darkopancev517/microbyte-rp2040/release/microbyte-rp2040-v1.0-rev/README.md

RELEASE NOTE:
    - microbyte-rp2040-v1.0-rev
        - Fixed tooling holes positions
        - Fixed tooling holes line width
