darkopancev517/microbyte-rp2040/microbyte-rp2040/microbyte-rp2040.kicad_pcb

## KiCad design microbyte-rp2040/microbyte-rp2040.kicad_pcb (2021-08-23)

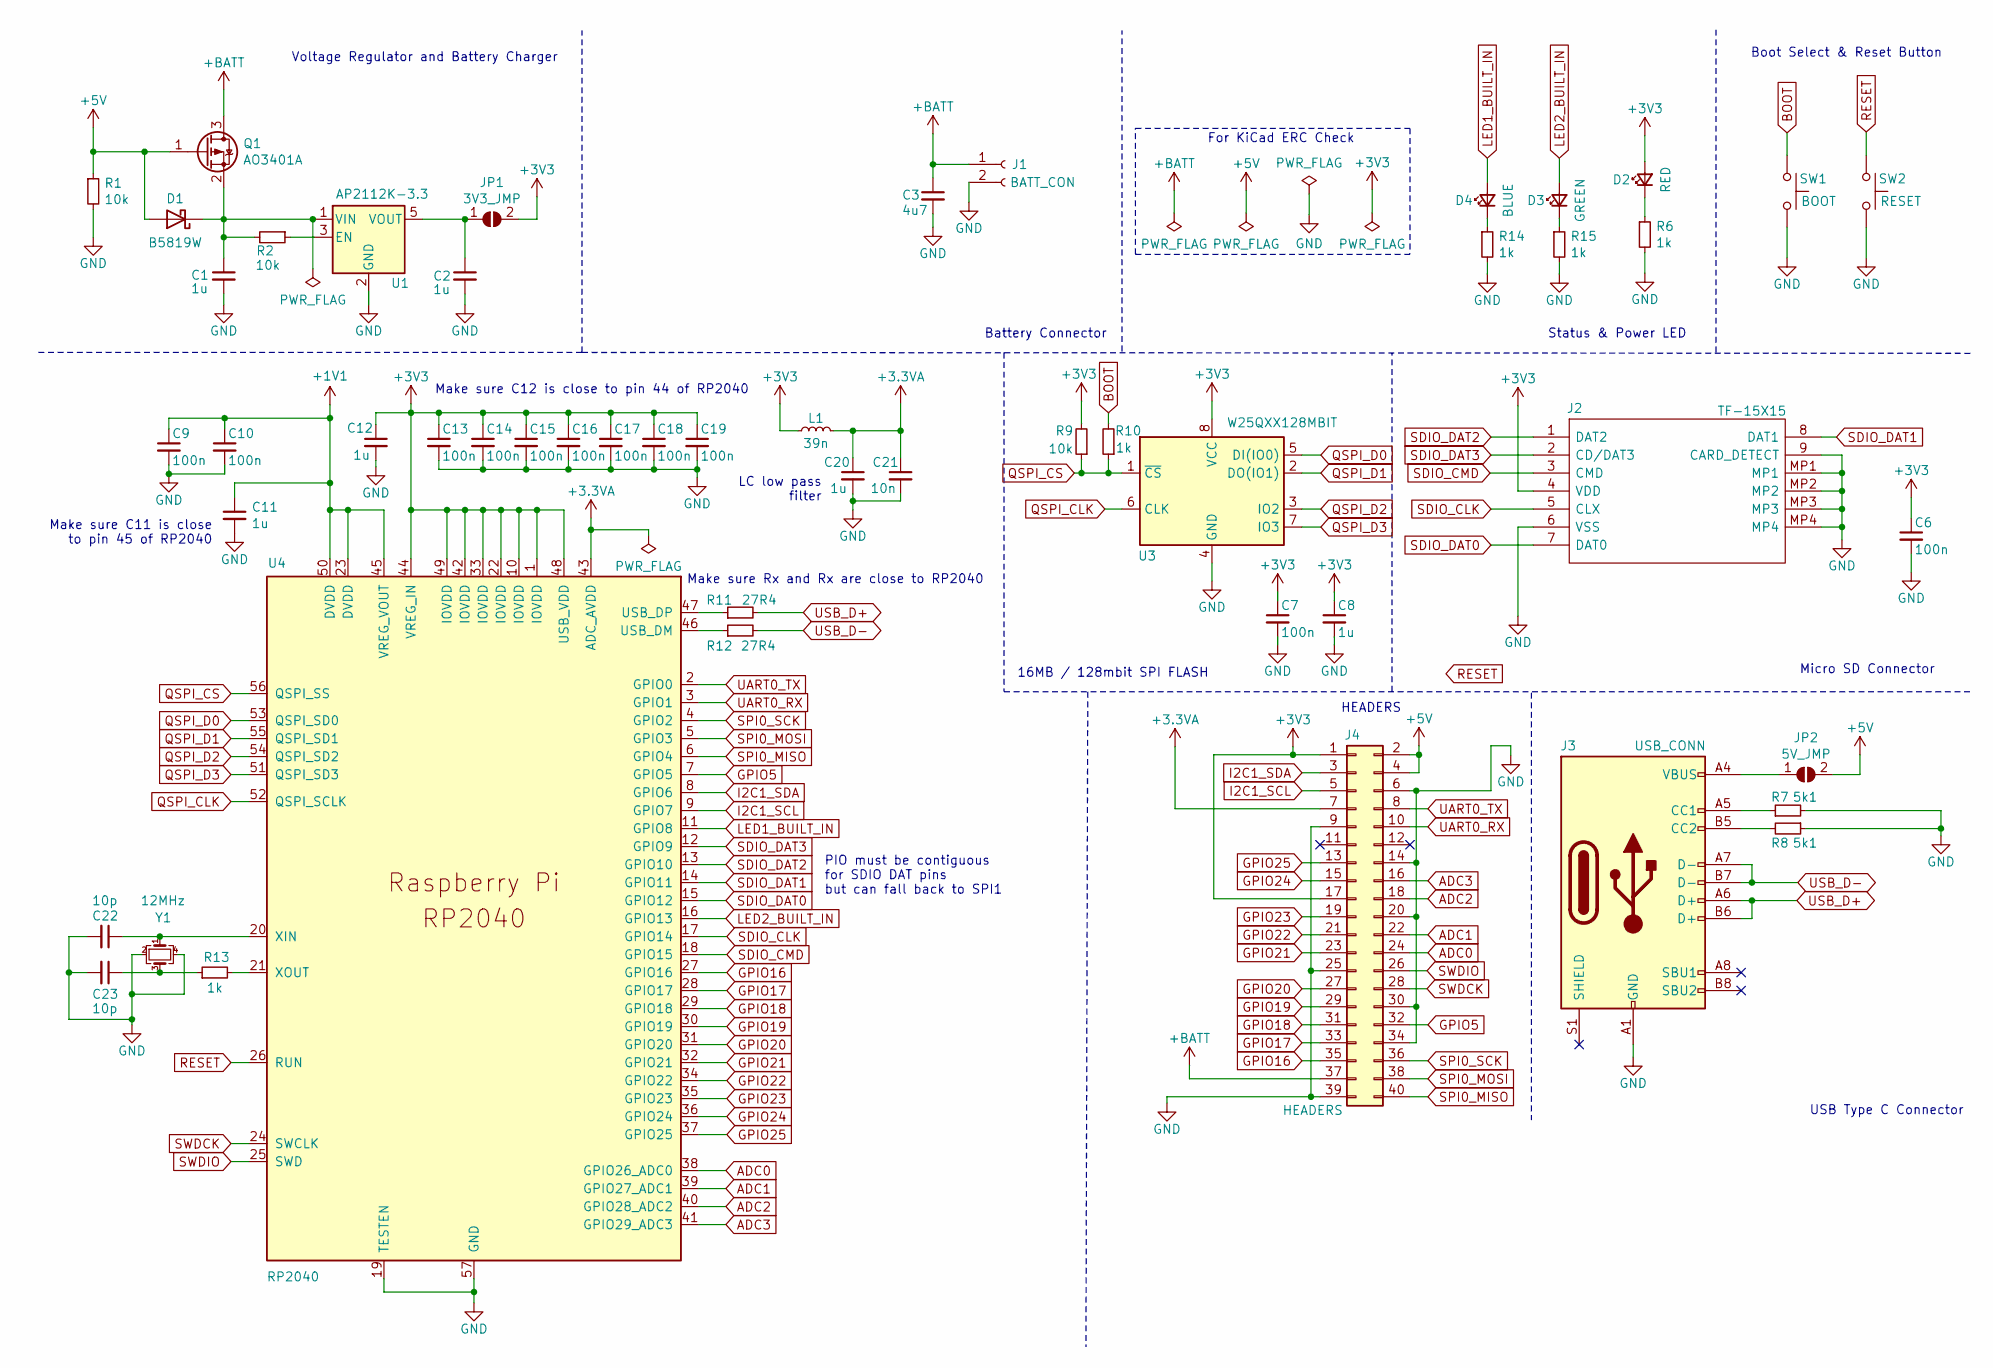
[picture p1: schematic microbyte-rp2040.sch, Microbyte RP2040]

Parts:
C1, C2, C8: 1u; C_0603_1608Metric; LCSC C15849
C3: 4u7; C_0603_1608Metric; LCSC C19666
C6, C7, C9, C10, C13, C14, C15, C16, C17, C18, C19: 100n; C_0402_1005Metric; LCSC C1525
C11, C12, C20: 1u; C_0402_1005Metric; LCSC C52923
C21: 10n; C_0402_1005Metric; LCSC C15195
C22, C23: 10p; C_0402_1005Metric; LCSC C32949
D1: B5819W; D_SOD-123; LCSC C8598
D2: RED; LED_0603_1608Metric; LCSC C2286
D3: GREEN; LED_0603_1608Metric; LCSC C72043
D4: BLUE; LED_0603_1608Metric; LCSC C72041
J1: BATT_CON; JST_PH_S2B-PH-SM4-TB_1x02-1MP_P2.00mm_Horizontal; LCSC C722680
J2: TF-15X15; TF15X15; Manufacturer_Part_Number TF-15X15; LCSC C111196
J3: USB_CONN; USB_C_Receptacle_HRO_TYPE-C-31-M-12; LCSC C165948
J4: HEADERS; PinHeader_2x20_P2.54mm_Vertical
JP1: 3V3_JMP; SolderJumper-2_P1.3mm_Open_RoundedPad1.0x1.5mm
JP2: 5V_JMP; SolderJumper-2_P1.3mm_Open_RoundedPad1.0x1.5mm
L1: 39n; L_0603_1608Metric; LCSC C74308
Q1: AO3401A; SOT-23; LCSC C700954
R1, R2: 10k; R_0603_1608Metric; LCSC C25804
R6, R10, R13, R14, R15: 1k; R_0402_1005Metric; LCSC C11702
R7, R8: 5k1; R_0402_1005Metric; LCSC C25905
R9: 10k; R_0402_1005Metric; LCSC C25744
R11, R12: 27R4; R_0402_1005Metric; LCSC C31439
SW1: BOOT; SW_SPST_TL3342; LCSC C318889
SW2: RESET; SW_SPST_TL3342; LCSC C318889
U1: AP2112K-3.3; SOT-23-5; LCSC C51118
U3: W25QXX128MBIT; SOIC-8_5.23x5.23mm_P1.27mm; LCSC C97521
U4: RP2040; RP2040-QFN-56; LCSC C2040
Y1: 12MHz; Crystal_SMD_3225-4Pin_3.2x2.5mm; LCSC C9002

Connections:
+1V1: C9.1, C10.1, C11.1, U4.23 (DVDD), U4.45 (VREG_VOUT), U4.50 (DVDD)
+3.3VA: C20.1, C21.1, J4.7, L1.2, U4.43 (ADC_AVDD)
+3V3: C6.1, C7.1, C8.1, C12.1, C13.1, C14.1, C15.1, C16.1, C17.1, C18.1, C19.1, D2.2 (A), J2.4 (VDD), J4.1, J4.17, JP1.2 (B), L1.1, R9.2, U3.8 (VCC), U4.1 (IOVDD), U4.10 (IOVDD), U4.22 (IOVDD), U4.33 (IOVDD), U4.42 (IOVDD), U4.44 (VREG_IN), U4.48 (USB_VDD), U4.49 (IOVDD)
+5V: D1.2 (A), J4.2, J4.4, JP2.2 (B), Q1.1 (G), R1.1
+BATT: C3.1, J1.1, J4.37, Q1.3 (D)
ADC0: J4.24, U4.38 (GPIO26_ADC0)
ADC1: J4.22, U4.39 (GPIO27_ADC1)
ADC2: J4.18, U4.40 (GPIO28_ADC2)
ADC3: J4.16, U4.41 (GPIO29_ADC3)
BOOT: R10.2, SW1.1
GND: C1.2, C2.2, C3.2, C6.2, C7.2, C8.2, C9.2, C10.2, C11.2, C12.2, C13.2, C14.2, C15.2, C16.2, C17.2, C18.2, C19.2, C20.2, C21.2, C22.2, C23.2, J1.2, J2.6 (VSS), J2.9 (CARD_DETECT), J2.MP1, J2.MP2, J2.MP3, J2.MP4, J3.A1 (GND), J3.A12 (GND), J3.B1 (GND), J3.B12 (GND), J4.6, J4.9, J4.14, J4.20, J4.25, J4.30, J4.34, J4.39, R1.2, R6.2, R7.2, R8.1, R14.2, R15.2, SW1.2, SW2.2, U1.2 (GND), U3.4 (GND), U4.19 (TESTEN), U4.57 (GND), Y1.2, Y1.4
GPIO5: J4.32, U4.7 (GPIO5)
GPIO16: J4.35, U4.27 (GPIO16)
GPIO17: J4.33, U4.28 (GPIO17)
GPIO18: J4.31, U4.29 (GPIO18)
GPIO19: J4.29, U4.30 (GPIO19)
GPIO20: J4.27, U4.31 (GPIO20)
GPIO21: J4.23, U4.32 (GPIO21)
GPIO22: J4.21, U4.34 (GPIO22)
GPIO23: J4.19, U4.35 (GPIO23)
GPIO24: J4.15, U4.36 (GPIO24)
GPIO25: J4.13, U4.37 (GPIO25)
I2C1_SCL: J4.5, U4.9 (GPIO7)
I2C1_SDA: J4.3, U4.8 (GPIO6)
LED1_BUILT_IN: D4.2 (A), U4.11 (GPIO8)
LED2_BUILT_IN: D3.2 (A), U4.16 (GPIO13)
unnamed: C1.1, D1.1 (K), Q1.2 (S), R2.2, U1.1 (VIN)
unnamed: C2.1, JP1.1 (A), U1.5 (VOUT)
unnamed: C22.1, U4.20 (XIN), Y1.1
unnamed: C23.1, R13.1, Y1.3
unnamed: D2.1 (K), R6.1
unnamed: D3.1 (K), R15.1
unnamed: D4.1 (K), R14.1
unnamed: J3.A4 (VBUS), J3.A9 (VBUS), J3.B4 (VBUS), J3.B9 (VBUS), JP2.1 (A)
unnamed: J3.A5 (CC1), R7.1
unnamed: J3.B5 (CC2), R8.2
unnamed: R2.1, U1.3 (EN)
unnamed: R11.1, U4.47 (USB_DP)
unnamed: R12.1, U4.46 (USB_DM)
unnamed: R13.2, U4.21 (XOUT)
QSPI_CLK: U3.6 (CLK), U4.52 (QSPI_SCLK)
QSPI_CS: R9.1, R10.1, U3.1 (~CS), U4.56 (QSPI_SS)
QSPI_D0: U3.5 (DI(IO0)), U4.53 (QSPI_SD0)
QSPI_D1: U3.2 (DO(IO1)), U4.55 (QSPI_SD1)
QSPI_D2: U3.3 (IO2), U4.54 (QSPI_SD2)
QSPI_D3: U3.7 (IO3), U4.51 (QSPI_SD3)
RESET: SW2.1, U4.26 (RUN)
SDIO_CLK: J2.5 (CLX), U4.17 (GPIO14)
SDIO_CMD: J2.3 (CMD), U4.18 (GPIO15)
SDIO_DAT0: J2.7 (DAT0), U4.15 (GPIO12)
SDIO_DAT1: J2.8 (DAT1), U4.14 (GPIO11)
SDIO_DAT2: J2.1 (DAT2), U4.13 (GPIO10)
SDIO_DAT3: J2.2 (CD/DAT3), U4.12 (GPIO9)
SPI0_MISO: J4.40, U4.6 (GPIO4)
SPI0_MOSI: J4.38, U4.5 (GPIO3)
SPI0_SCK: J4.36, U4.4 (GPIO2)
SWDCK: J4.28, U4.24 (SWCLK)
SWDIO: J4.26, U4.25 (SWD)
UART0_RX: J4.10, U4.3 (GPIO1)
UART0_TX: J4.8, U4.2 (GPIO0)
USB_D+: J3.A6 (D+), J3.B6 (D+), R11.2
USB_D-: J3.A7 (D-), J3.B7 (D-), R12.2

Notes on the sheet:
Make sure C12 is close to pin 44 of RP2040
Voltage Regulator and Battery Charger
Status & Power LED
Boot Select & Reset Button
USB Type C Connector
Micro SD Connector
HEADERS
Make sure Rx and Rx are close to RP2040
Make sure C11 is close to pin 45 of RP2040
LC low pass filter
16MB / 128mbit SPI FLASH
PIO must be contiguous for SDIO DAT pins but can fall back to SPI1
For KiCad ERC Check
Battery Connector

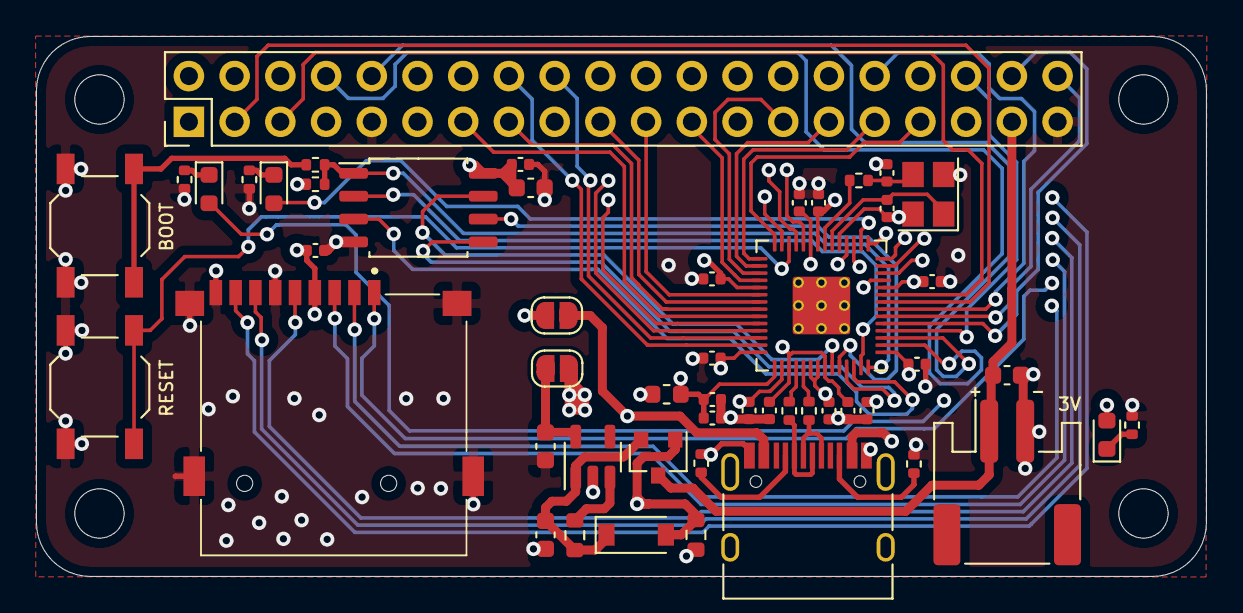
[picture p2: board microbyte-rp2040.kicad_pcb from above]

Board: 4 copper layers, 65.0 x 30.0 mm, 51 parts (0 on the bottom side), 62 nets.
