darkopancev517/microbyte-rp2040/(commit log)

2021-08-20 microbyte-rp2040-v1.1 released
    [microbyte-rp2040-B_Cu.gbr, microbyte-rp2040-B_Mask.gbr, microbyte-rp2040-B_Paste.gbr, microbyte-rp2040-B_SilkS.gbr, microbyte-rp2040-Edge_Cuts.gbr, microbyte-rp2040-F_Cu.gbr, microbyte-rp2040-F_Mask.gbr, microbyte-rp2040-F_Paste.gbr]
2021-08-23 remove tooling holes
    [microbyte-rp2040.kicad_pcb]
