darkopancev517/microbyte-rp2040/(notices)

Notices in the files:
microbyte-rp2040/microbyte-rp2040.kicad_pcb:
License: MIT - Copyright 2018 StudioPieters®
